CandeiasV2/VGA-EEPROM-Image-Display/PCB_VideoCard/3D_VideoCard_PCB_Front.png

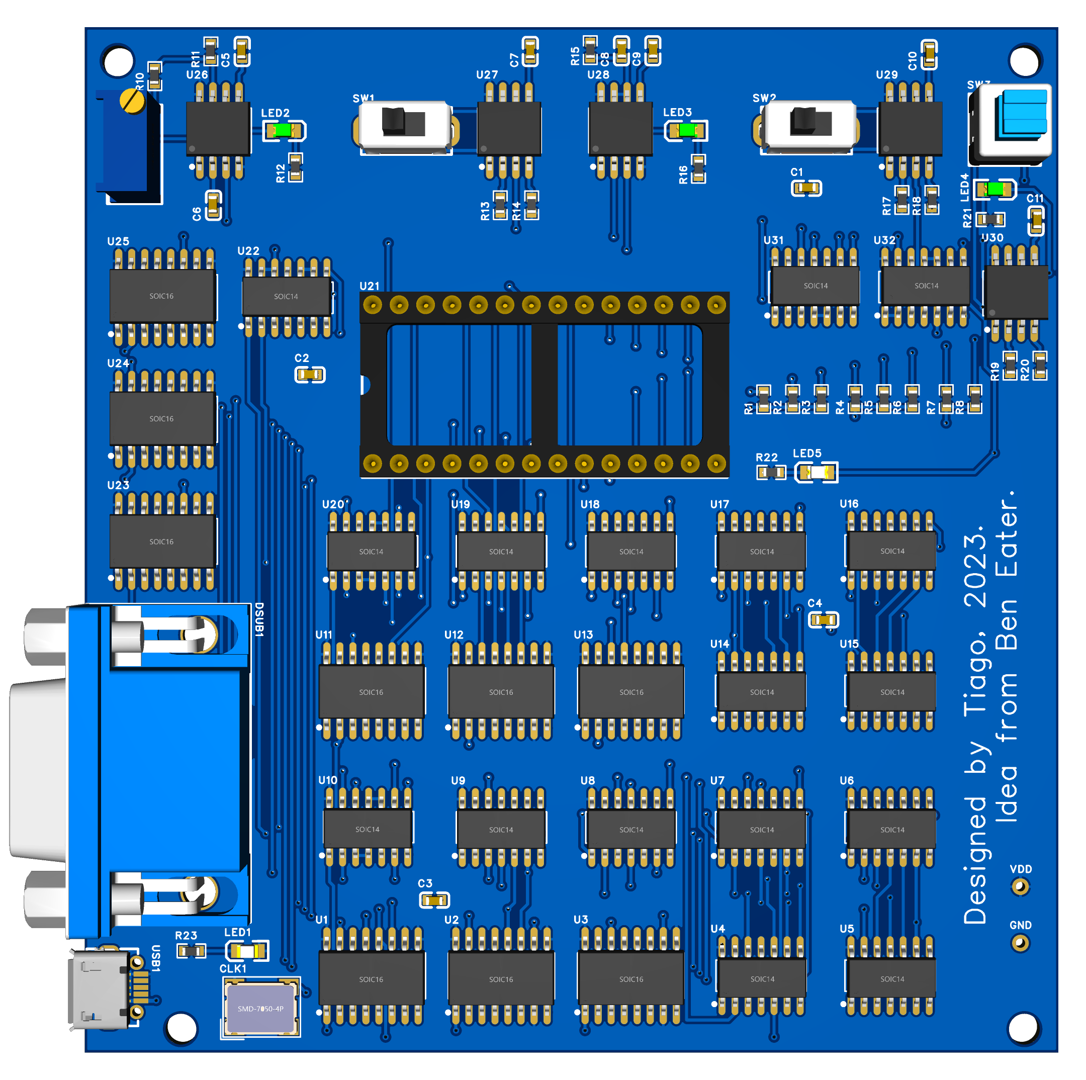
PCB_VideoCard/3D_VideoCard_PCB_Front.png
