CandeiasV2/VGA-EEPROM-Image-Display/PCB_VideoCard/BOM_VideoCardBoard.xlsx

No. | Quantity | Comment | Designator | Value | Manufacturer Part | Manufacturer | Supplier Part | Supplier
1 | 5 | 100nF | C1,C2,C3,C4,C8 | 100nF | CL10B104KB8NNNC | SAMSUNG(三星) | C1591 | LCSC
2 | 5 | 10nF | C5,C7,C9,C10,C11 | 10nF | CL10B103KB8NNNC | SAMSUNG(三星) | C1589 | LCSC
3 | 1 | 22uF | C6 | 22uF | CL10A226MP8NUNE | SAMSUNG(三星) | C86295 | LCSC
4 | 1 | 10MHz | CLK1 | 10MHz | S7D10.000000A20F30T | SCTF(星通时频) | C386958 | LCSC
5 | 1 | VGA-002 | DSUB1 |  | VGA-002 | BOOMELE(博穆精密) | C138387 | LCSC
6 | 1 | 17-21SYGC/S530-E3/TR8 | LED1 |  | 17-21SYGC/S530-E3/TR8 | EVERLIGHT(亿光) | C142303 | LCSC
7 | 3 | SZYY0805Y | LED2,LED3,LED4 |  | SZYY0805Y | yongyu(永裕光电) | C434436 | LCSC
8 | 1 | TZ-P2-0805RTCS2-0.8T | LED5 |  | TZ-P2-0805RTCS2-0.8T | TUOZHAN(拓展光电) | C688884 | LCSC
9 | 2 | 3.65kΩ | R1,R4 | 3.65kΩ | 0603WAF3651T5E | UNI-ROYAL(厚声) | C22999 | LCSC
10 | 3 | 1.8kΩ | R2,R5,R11 | 1.8kΩ | 0603WAF1801T5E | UNI-ROYAL(厚声) | C4177 | LCSC
11 | 2 | 866Ω | R3,R6 | 866Ω | 0603WAF8660T5E | UNI-ROYAL(厚声) | C23123 | LCSC
12 | 1 | 1.5kΩ | R7 | 1.5kΩ | 0603WAF1501T5E | UNI-ROYAL(厚声) | C22843 | LCSC
13 | 1 | 680Ω | R8 | 680Ω | 0603WAF6800T5E | UNI-ROYAL(厚声) | C23228 | LCSC
14 | 1 | 1MΩ | R9 | 1MΩ | 3296W-1-105-8mm | BOCHEN(博晨) | C330438 | LCSC
15 | 7 | 1kΩ | R10,R13,R14,R17,R18,R19,R20 | 1kΩ | 0603WAF1001T5E | UNI-ROYAL(厚声) | C21190 | LCSC
16 | 5 | 220Ω | R12,R16,R21,R22,R23 | 220Ω | 0603WAF2200T5E | UNI-ROYAL(厚声) | C22962 | LCSC
17 | 1 | 1MΩ | R15 | 1MΩ | 0603WAF1004T5E | UNI-ROYAL(厚声) | C22935 | LCSC
18 | 2 | SS12D07VG5 087 | SW1,SW2 |  | SS12D07VG5 087 | SHOU HAN(首韩) | C2939727 | LCSC
19 | 1 | YTSPS-22E70L | SW3 |  | YTSPS-22E70L | YIYUAN(怡远) | C2911140 | LCSC
20 | 9 | SN74LS161ANSR | U1,U2,U3,U11,U12,U13,U23,U24,U25 |  | SN74LS161ANSR | TI(德州仪器) | C7741 | LCSC
21 | 4 | SN74LS04DR | U4,U5,U14,U15 |  | SN74LS04DR | TI(德州仪器) | C6796 | LCSC
22 | 8 | SN74LS30DR | U6,U7,U8,U9,U16,U17,U18,U19 |  | SN74LS30DR | TI(德州仪器) | C7759 | LCSC
23 | 5 | SN74HC00DR | U10,U20,U22,U31,U32 |  | SN74HC00DR | TI(德州仪器) | C10090 | LCSC
24 | 1 | DS1009-28AT1WX-0A2 | U21 |  | DS1009-28AT1WX-0A2 | CONNFLY | C72121 | LCSC
25 | 5 | NE555PSR | U26,U27,U28,U29,U30 |  | NE555PSR | TI(德州仪器) | C105601 | LCSC
26 | 1 | BTC-MC7S-43 | USB1 |  | BTC-MC7S-43 | DGBZ(东莞博众) | C2908218 | LCSC
