CandeiasV2/VGA-EEPROM-Image-Display/PCB_VideoCard/SCH_VideoCardBoard.pdf

1

2

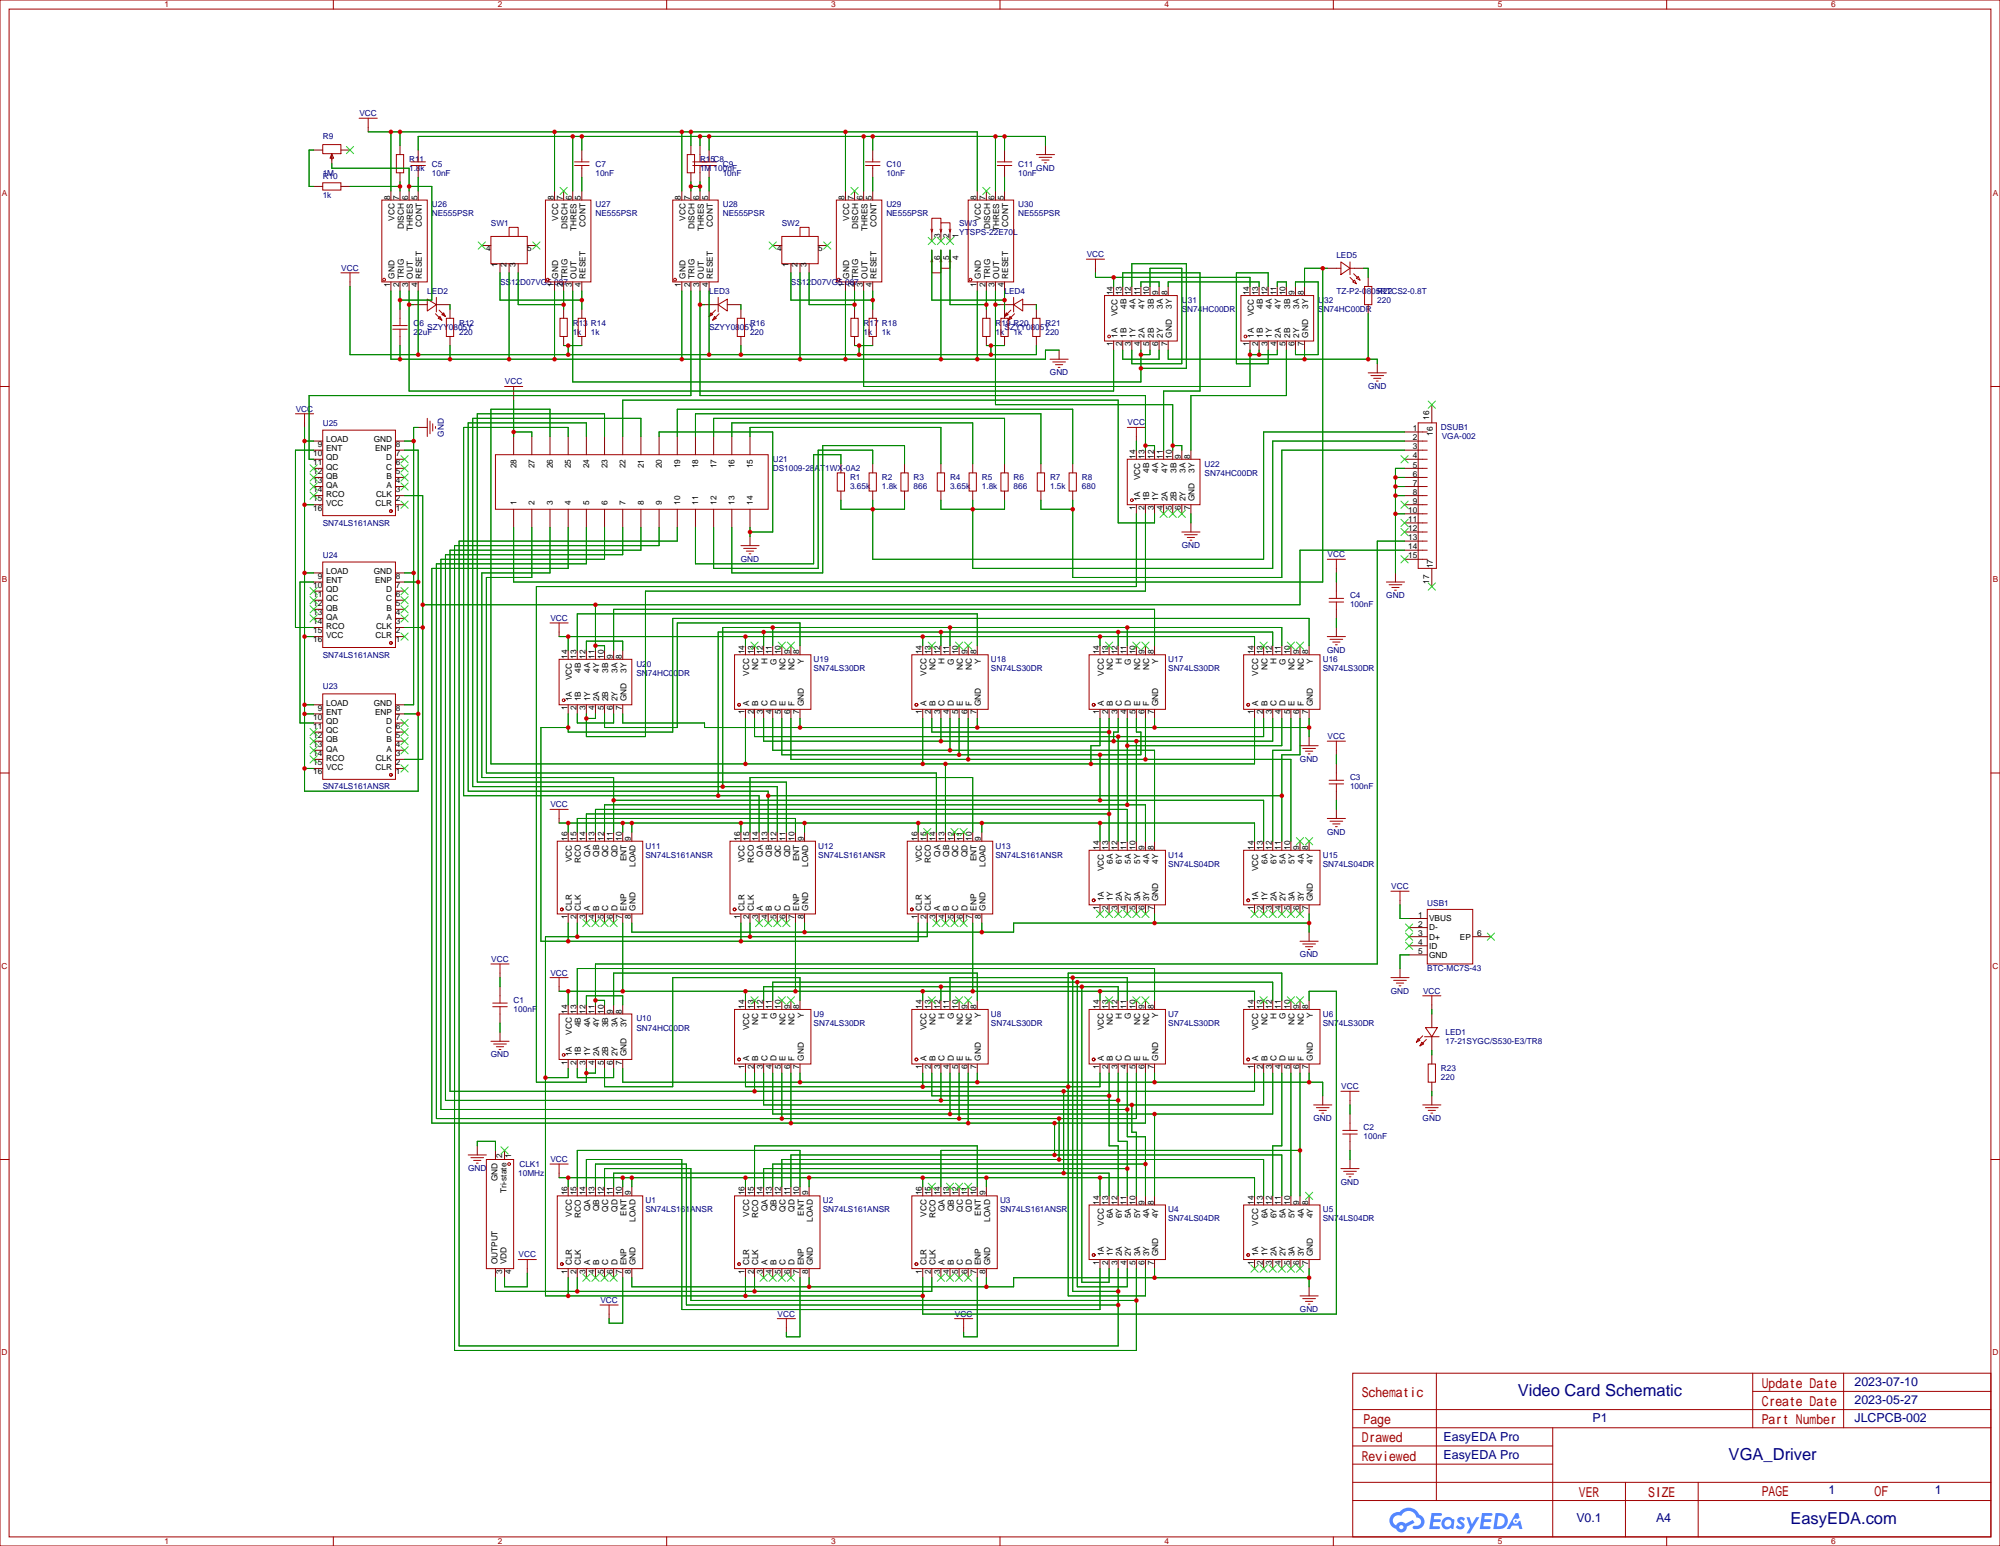
[picture p8: page 1]

VCC
LOAD 9
ENT 10 QD 11 QC 12 QB 13 QA 14 RCO 15 VCC 16

SN74LS161ANSR

9 ENT 10 QD 11 QC 12 QB 13 QA 14 RCO 15 VCC 16
