CandeiasV2/VGA-EEPROM-Image-Display/(commit log)

2023-07-11 PCB Files
2024-09-12 Photo of the PCB
